syedjafri06193/Custom-STM32-Dev-Board-proj/(commit log)

2026-09-11 Add project description to README
    Added a project description for the custom STM32 development board.
2026-09-18 Add v1: STM32G474 industrial sensor logger implementation
2026-10-29 Consolidate docs, add CI with sanitizers and the ARM cross-build
    - Add GitHub Actions CI: firmware host tests, executable design rules,
    tool tests, the same firmware tests under ASan + UBSan, the
    arm-none-eabi cross-build for the STM32G474RET6, and the bench report
    - firmware/Makefile: `make sanitize` and an EXTRA_CFLAGS hook (all suites
    pass clean under ASan + UBSan)
    - Move docs/ and v1/docs/ into 1—Documentation/ with an index; update links
    and references in fdcan.c, stm32g474.h and board.yaml
    - README: CI badge, layout tree
